mjw25/ECE411_Team10_F19/Initial Perf Board.jpg

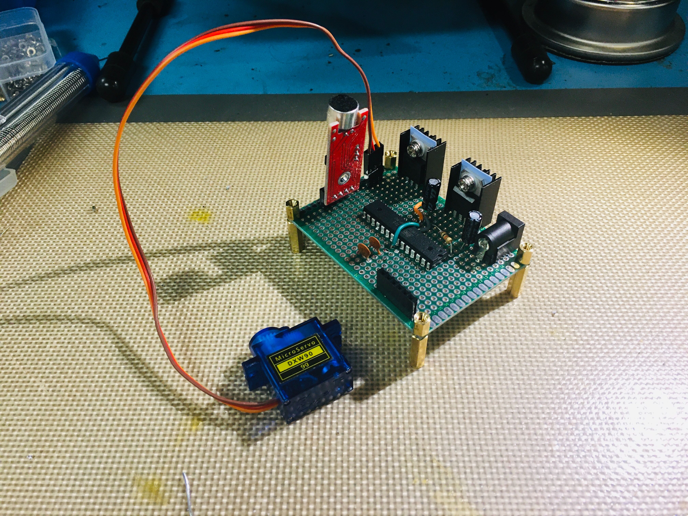
Initial Perf Board.jpg
