mjw25/ECE411_Team10_F19/Breadboard Preliminary Prototype.png

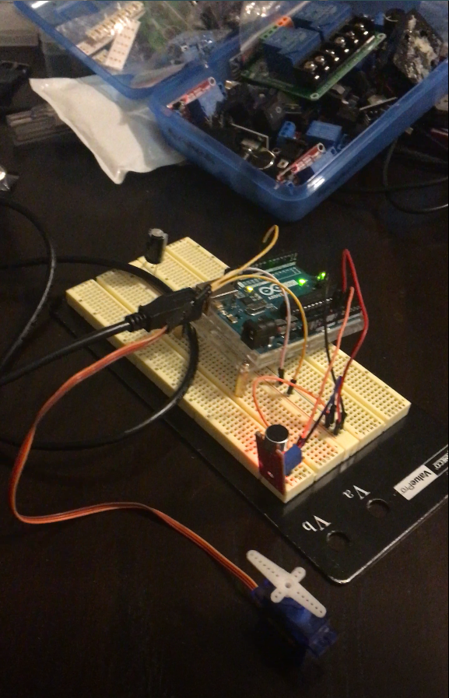
Breadboard Preliminary Prototype.png
