mjw25/ECE411_Team10_F19/README.md

# ECE411_Team10_F19
Practicum Project for ECE411 at PSU, Team 10, Fall 2019
