mjw25/ECE411_Team10_F19/Initial Breadboard Code.png

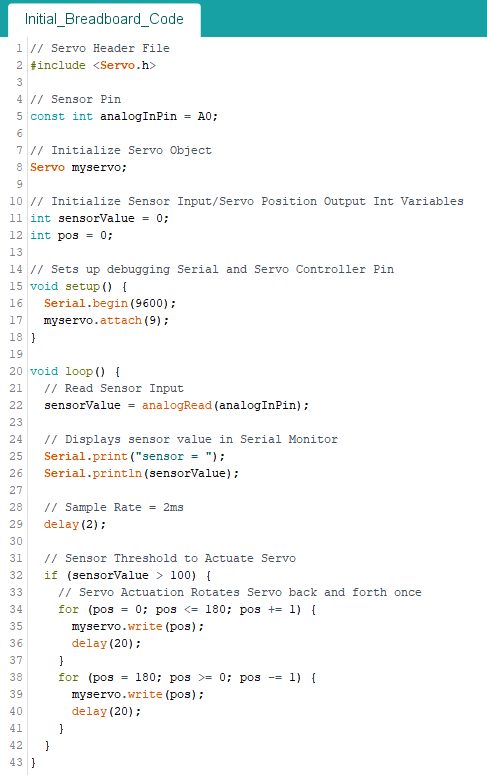
Initial Breadboard Code.png
