mjw25/ECE411_Team10_F19/Level 0.png

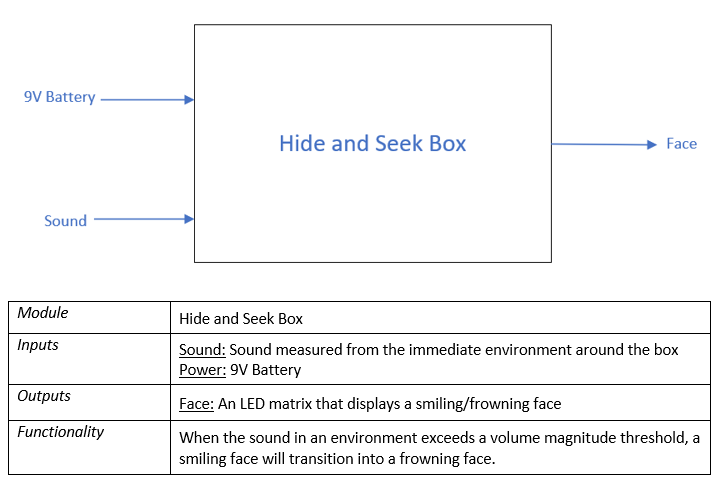
Level 0.png
