mjw25/ECE411_Team10_F19/Level 1 - Module 1.png

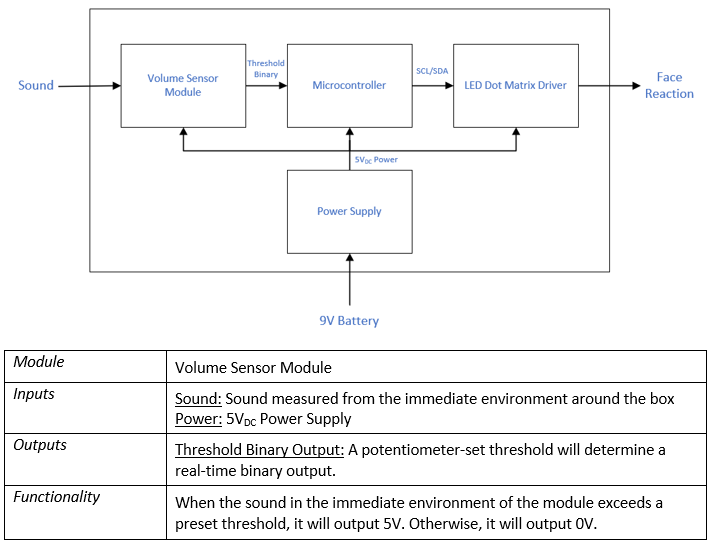
Level 1 - Module 1.png
