mjw25/ECE411_Team10_F19/Level 1 - Modules 2, 3, 4.png

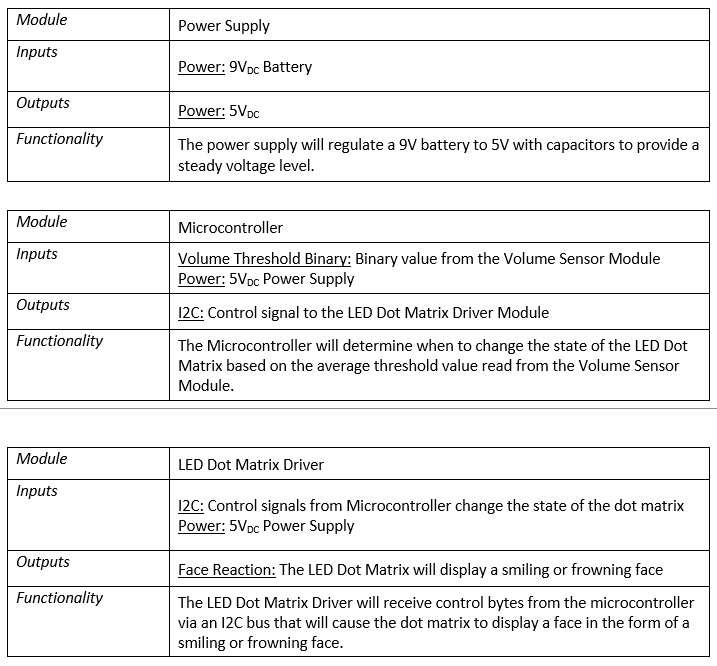
Level 1 - Modules 2, 3, 4.png
