mjw25/ECE411_Team10_F19/OSH_PCB_Top_Bottom.PNG

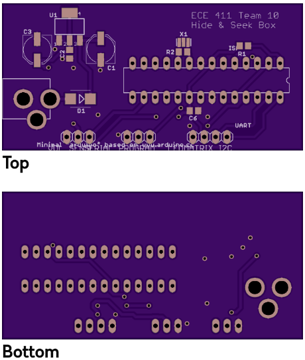
OSH_PCB_Top_Bottom.PNG
