mjw25/ECE411_Team10_F19/Preliminary Schematic.png

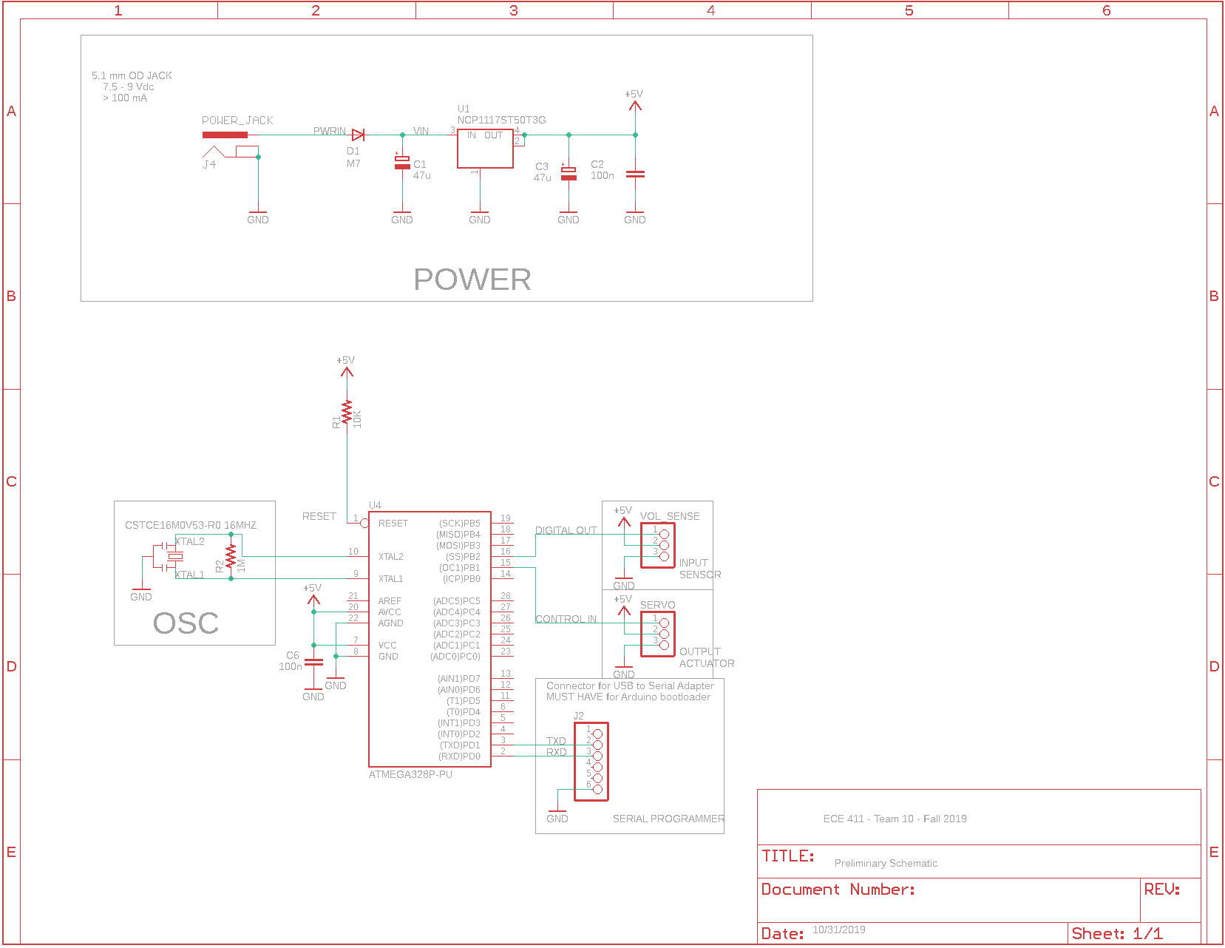
Preliminary Schematic.png
