mjw25/ECE411_Team10_F19/Project View.png

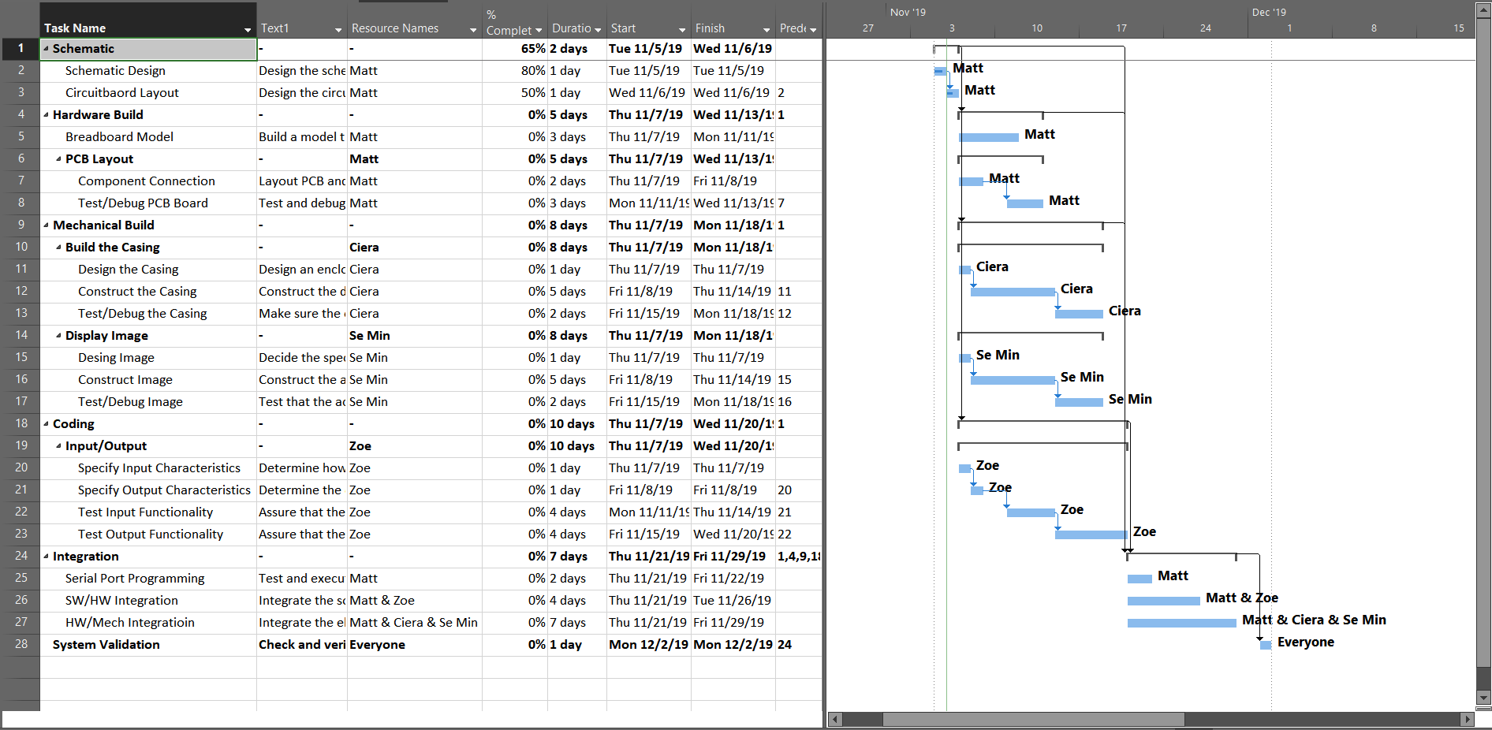
Project View.png
