mjw25/ECE411_Team10_F19/Routed Board - Prototype.png

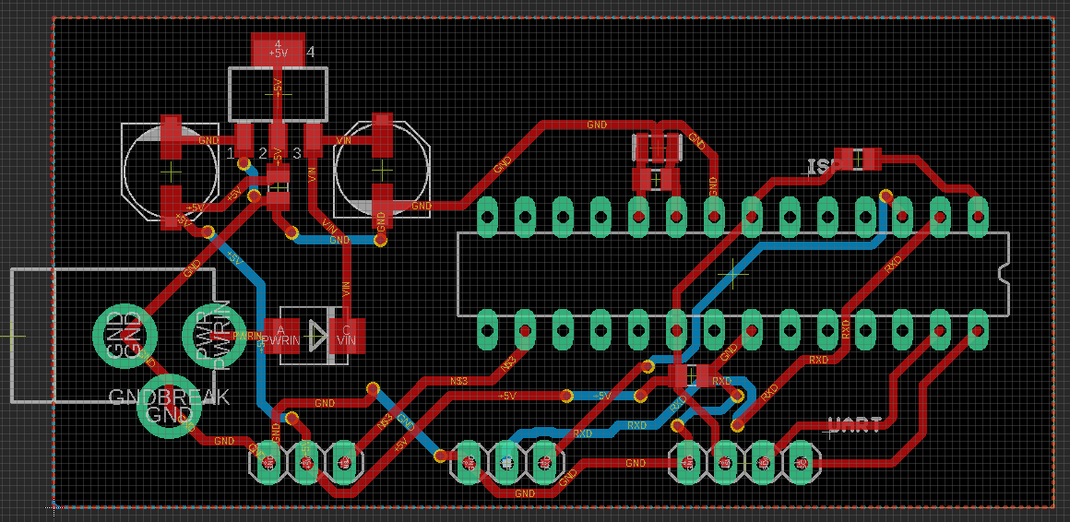
Routed Board - Prototype.png
