mjw25/ECE411_Team10_F19/Updated_Board_11-20.png

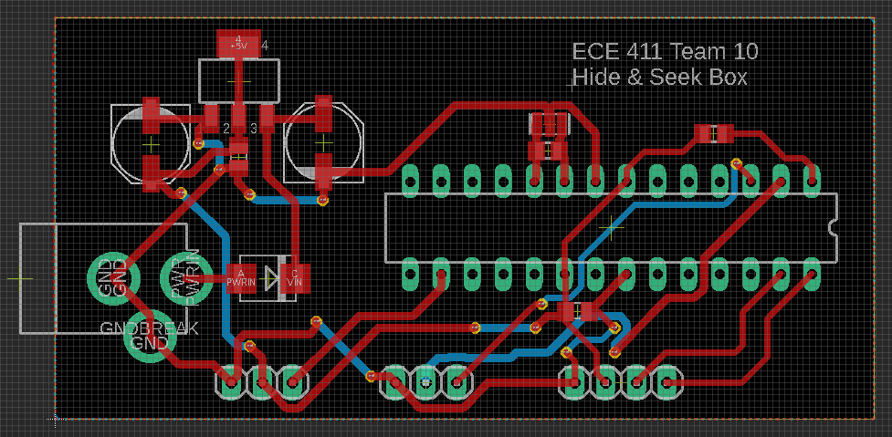
Updated_Board_11-20.png
