mjw25/ECE411_Team10_F19/Prototype BOM.xlsx

Sheet: BillOfMaterials
Hide and Seek Box
 | Assembly Name : | Prototype Assembly |  |  |  |  |  |  | [42]
 | Assembly Number : | 1
 | Assembly Revision : | 1
 | Approval Date : | 2019-11-13
 | Part Count : | 15
 | Total Cost : | $16.34
Part # | Part Name | Description | Package | Manufacturer | Distributor | Link | Qty | Units | Picture | Unit Cost | Cost
C0805X104K5RAC3316 | C2, C6 | 100n Ceramic Capacitor | C0805 | Kemet | Mouser | Link (https://www.mouser.com/ProductDetail/KEMET/C0805X104K5RAC3316) | 2 | Pieces |  | $0.34 | $0.68
EEE-TC1V470P | C1, C3 | 47u Electrolytic Capacitor | Panasonic D | Panasonic | Mouser | Link (https://www.mouser.com/ProductDetail/Panasonic/EEE-TC1V470P) | 2 | Pieces |  | $0.95 | $1.90
WCR0805-10KFI | R1 | SMD 10K-Ohm Thick Film Resistor | R0805 | Welwyn Components/ TT Electronics | Mouser | Link (https://www.mouser.com/ProductDetail/Welwyn-Components-TT-Electronics/WCR0805-10KFI) | 1 | Pieces |  | $0.10 | $0.10
CR0805-FX-1004ELF | R2 | SMD 1M-Ohm Thick Film Resistor | R0805 | Bourns | Mouser | Link (https://www.mouser.com/ProductDetail/Bourns/CR0805-FX-1004ELF) | 1 | Pieces |  | $0.10 | $0.10
UA78M05IDCYR | U1 | 5V Regulator - NPC1117ST50T3G | SOT223 | Texas Instruments | Mouser | Link (https://www.mouser.com/ProductDetail/Texas-Instruments/UA78M05IDCYR) | 1 | Pieces |  | $0.62 | $0.62
P6SMB39CA-Q | D1 | TVS Diode 600W | SMB | Bourns | Mouser | Link (https://www.mouser.com/ProductDetail/Bourns/P6SMB39CA-Q) | 1 | Pieces |  | $0.46 | $0.46
30.359 | N/A | Header Pins | Header Pins | Altech | Mouser | Link (https://www.mouser.com/ProductDetail/Altech/30359) | 2 | Pieces |  | $1.28 | $2.56
ATMEGA328P-PU | U4 | 8-Bit Microcontroller | DIL28-3 | Microchip Technology/ Atmel | Mouser | Link (https://www.mouser.com/ProductDetail/Microchip-Technology-Atmel/ATMEGA328P-PU) | 1 | Pieces |  | $2.14 | $2.14
CSTCE16M0V53A-R0 | X1 | 16MHz Resonator | CSTCE16M0V53 | Murata Electronics | element14 | Link (https://sg.element14.com/murata/cstce16m0v53-r0/resonator-smd-16mhz/dp/1401454?CMP=GRHB-OCTOPART) | 1 | Pieces |  | $0.58 | $0.58
PRT-10811 | J4 | Power Jack | Barrel Jack | SparkFun | Mouser | Link (https://www.mouser.com/ProductDetail/SparkFun/PRT-10811) | 1 | Pieces |  | $0.95 | $0.95
HT16K33 | N/A | I2C 8x8 LED Matrix | N/A | Keyestudio | Amazon | Link (https://www.amazon.com/KEYESTUDIO-Matrix-HT16K33-Arduino-Raspberry/dp/B0179AGI9K) | 1 | Pieces |  | $4.33 | $4.33
B07R452F6J | N/A | Microphone Sensor | N/A | Devmo | Amazon | Link (https://www.amazon.com/gp/product/B07R452F6J/ref=ppx_yo_dt_b_asin_title_o04_s01?ie=UTF8&psc=1) | 1 | Pieces |  | $1.92 | $1.92
 | Total |  |  |  |  |  | 15 |  |  |  | $16.34

Sheet: Revisions
Revision History
 | Assembly Name :
 | Assembly Number :
Revision | Revision Summary | Approval Date
