mjw25/ECE411_Team10_F19/BOM - Prototype.png

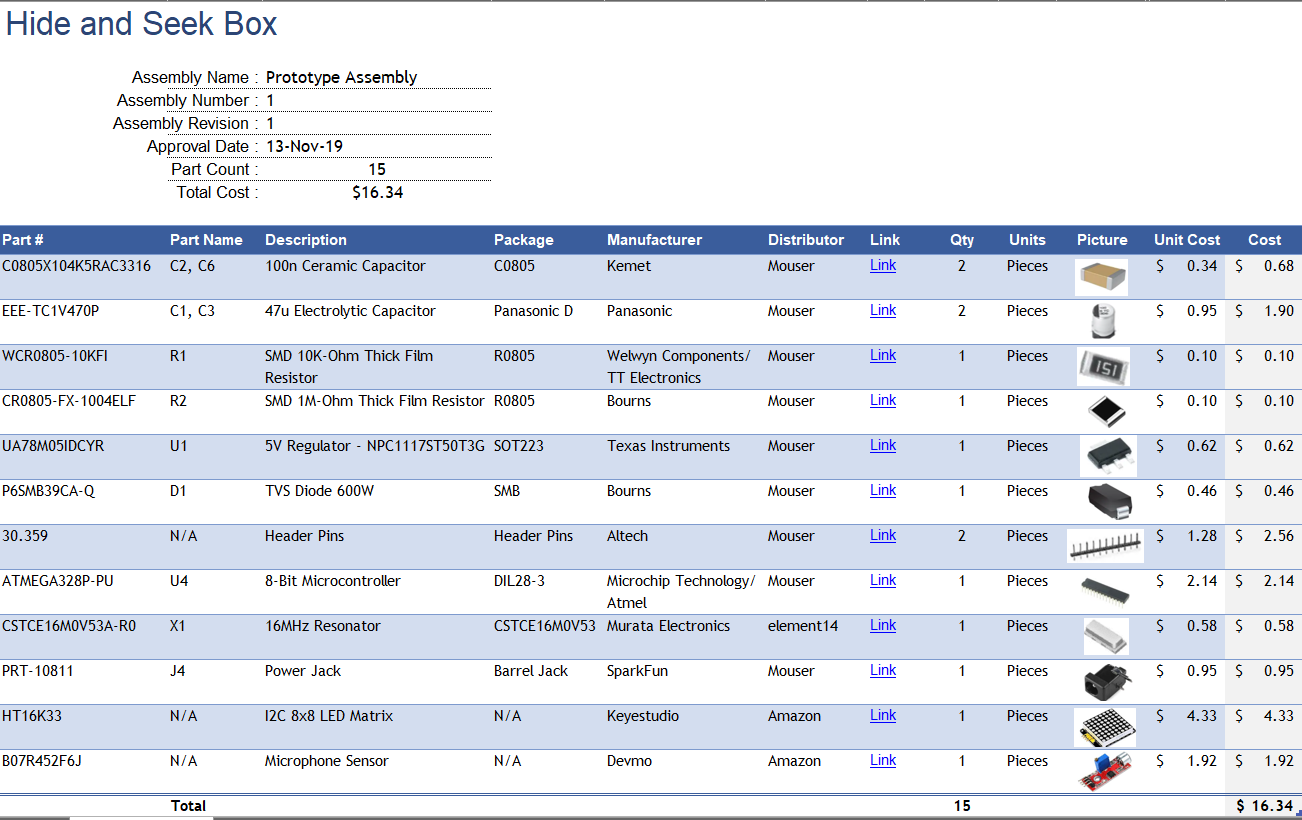
BOM - Prototype.png
