mjw25/ECE411_Team10_F19/ECE411-Box.stl

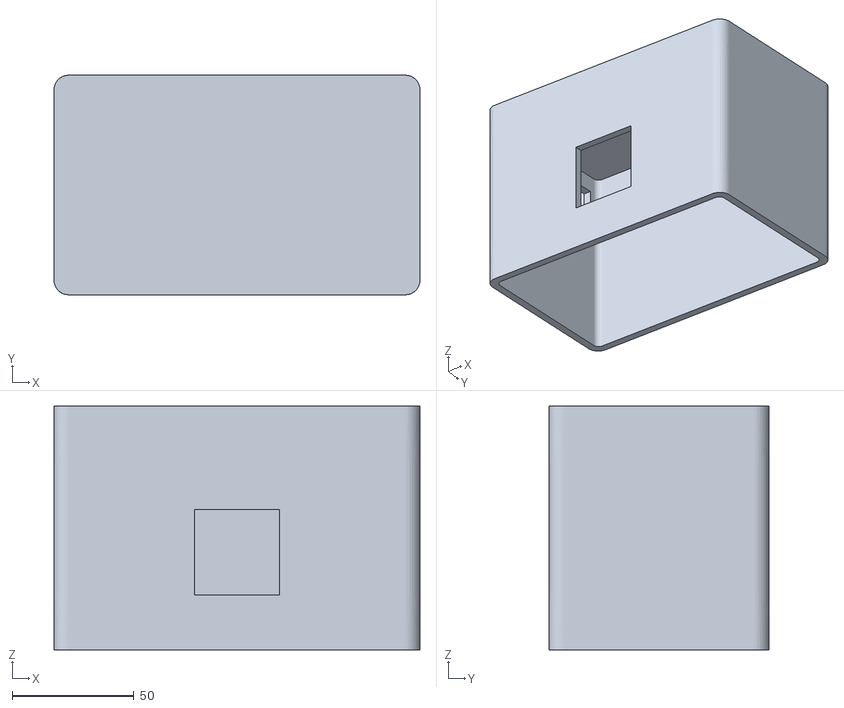
[picture p16: CAD file, 2019-12-13]
ECE411-Box.stl
150.0 x 90.0 x 100.0
