mjw25/ECE411_Team10_F19/ECE411-Lid.stl

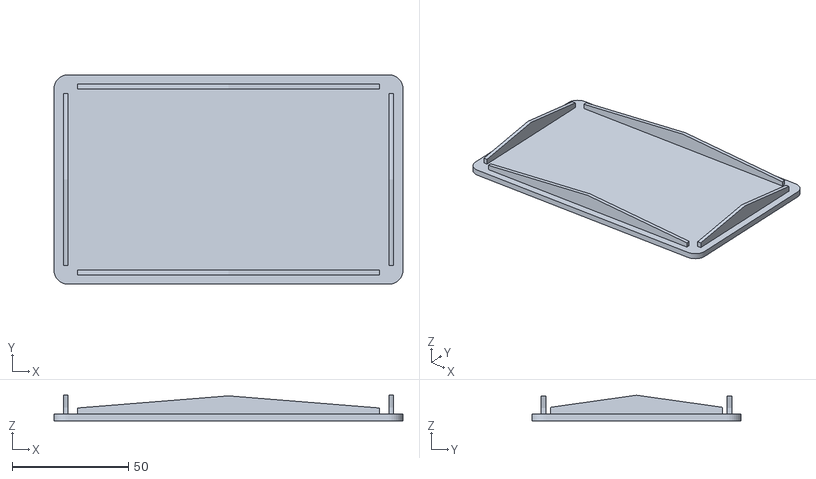
[picture p17: CAD file, 2019-12-13]
ECE411-Lid.stl
150.0 x 90.0 x 11.0
