mjw25/ECE411_Team10_F19/Updated_Schematic_11-20.brd

## EAGLE design Updated_Schematic_11-20.brd (2019-11-20)

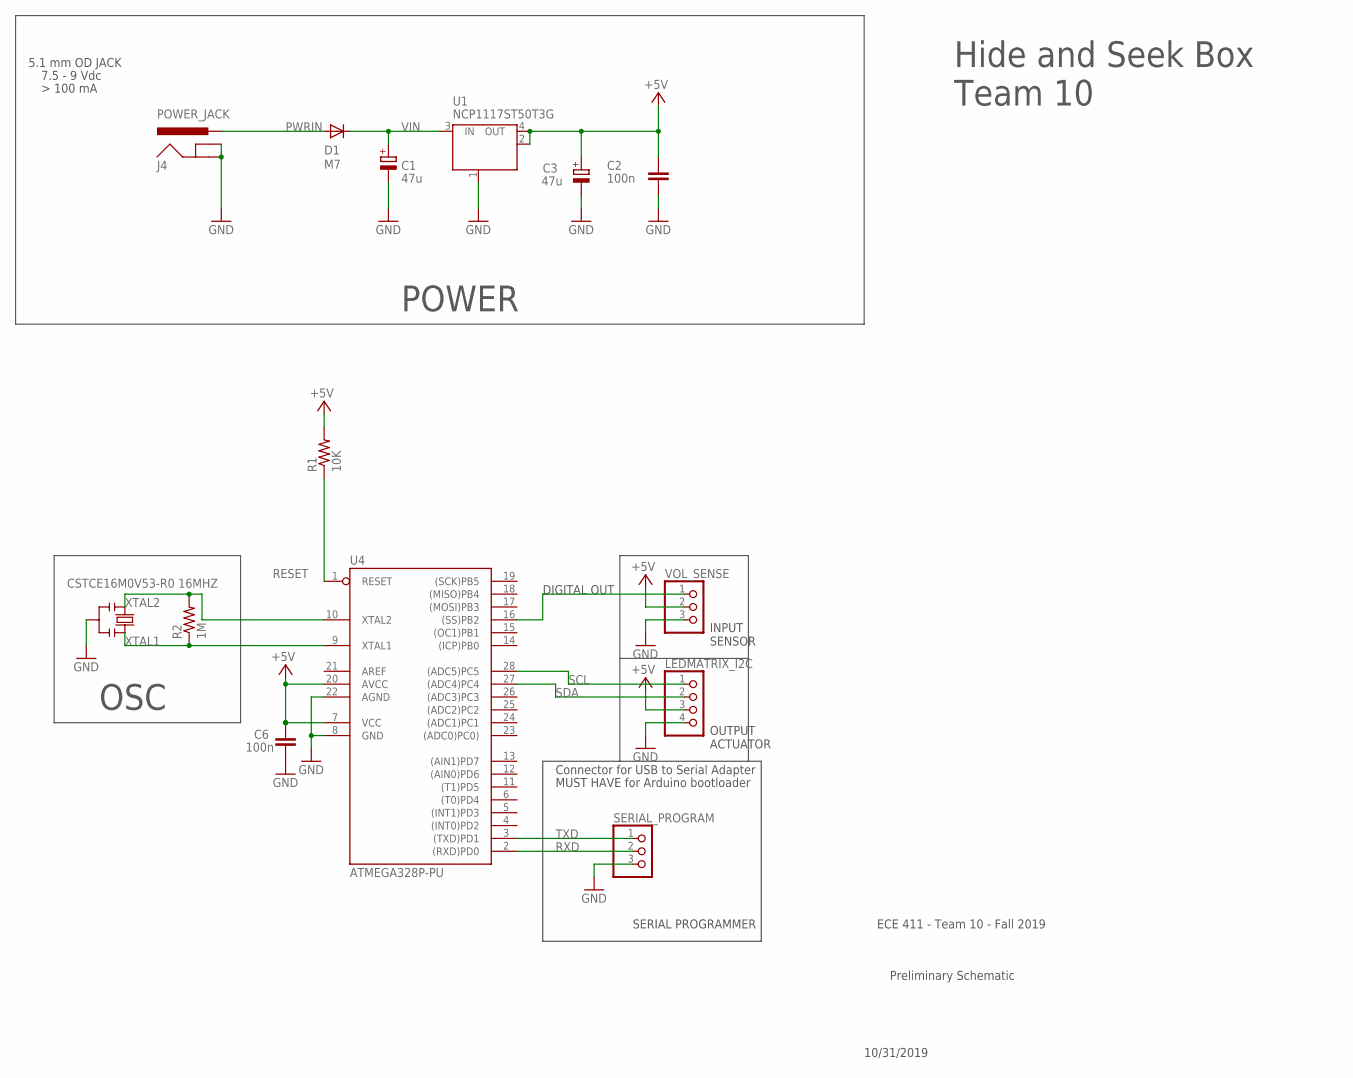
[picture p18: schematic Updated_Schematic_11-20.sch]

Parts:
C1, C3: 47u; PANASONIC_D
C2, C6: 100n; C0805
D1: M7; SMB
J4: POWER_JACK; POWER_JACK_PTH
LEDMATRIX_I2C: PINHD-1X4; 1X04
R1: 10K; R0805
R2: 1M; R0805
SERIAL_PROGRAM: PINHD-1X3; 1X03
U1: NCP1117ST50T3G; SOT223
U4: ATMEGA328P-PU; DIL28-3
VOL_SENSE: PINHD-1X3; 1X03
X1: CSTCE16M0V53-R0 16MHZ; RESONATOR

Connections:
+5V: C2.2, C3.+, C6.2, LEDMATRIX_I2C.3, R1.2, U1.2 (OUT), U1.4 (OUT), U4.7 (VCC), U4.20 (AVCC), VOL_SENSE.2
GND: C1.-, C2.1, C3.-, C6.1, J4.GND, J4.GNDBREAK, LEDMATRIX_I2C.4, SERIAL_PROGRAM.3, U1.1 (GND/ADJ), U4.8 (GND), U4.22 (AGND), VOL_SENSE.3, X1.2
unnamed: U4.16 ((SS)PB2), VOL_SENSE.1
PWRIN: D1.A, J4.PWR
RESET: R1.1, U4.1 (RESET)
RXD: SERIAL_PROGRAM.2, U4.2 ((RXD)PD0)
SCL: LEDMATRIX_I2C.1, U4.28 ((ADC5)PC5)
SDA: LEDMATRIX_I2C.2, U4.27 ((ADC4)PC4)
TXD: SERIAL_PROGRAM.1, U4.3 ((TXD)PD1)
VIN: C1.+, D1.C, U1.3 (IN)
XTAL1: R2.1, U4.9 (XTAL1), X1.3
XTAL2: R2.2, U4.10 (XTAL2), X1.1

Notes on the sheet:
7.5 - 9 Vdc
POWER
OSC
5.1 mm OD JACK
Connector for USB to Serial Adapter
MUST HAVE for Arduino bootloader
DIGITAL OUT
SERIAL PROGRAMMER
INPUT SENSOR
OUTPUT ACTUATOR
Preliminary Schematic
10/31/2019
ECE 411 - Team 10 - Fall 2019
Hide and Seek Box Team 10

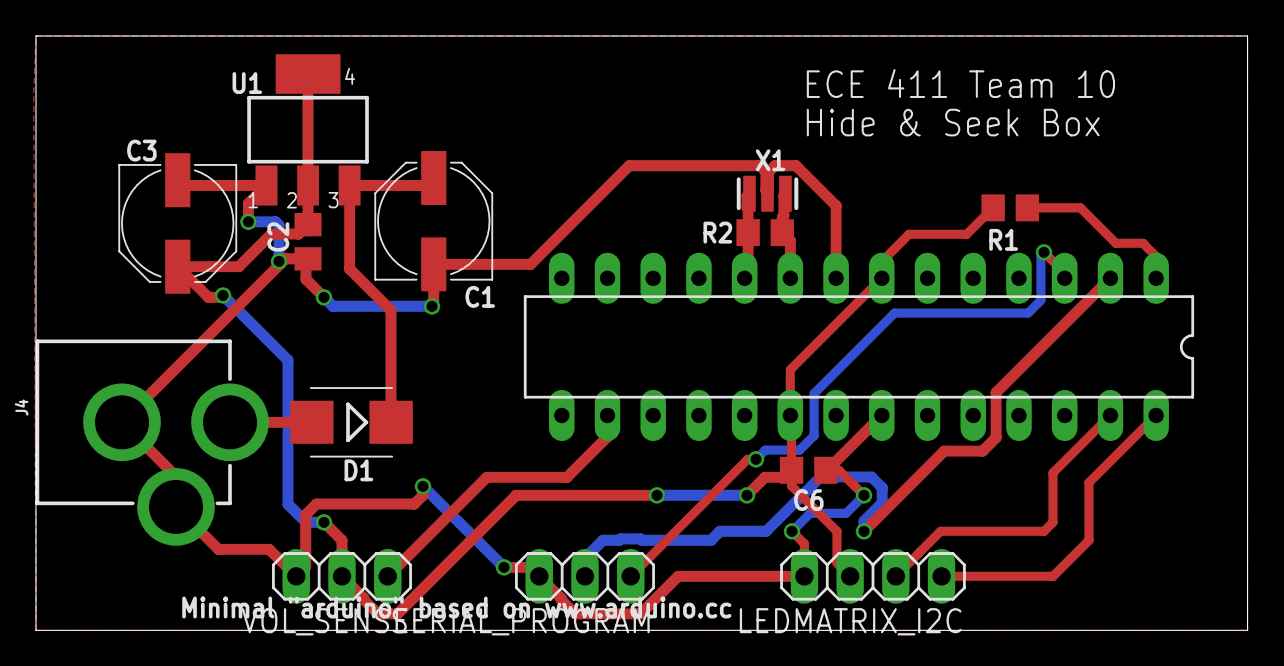
[picture p19: board Updated_Schematic_11-20.brd from above]

Board: 2 copper layers, 67.3 x 33.0 mm, 14 parts (0 on the bottom side), 12 nets.
