mjw25/ECE411_Team10_F19/tooloud.ino

#include <Wire.h>
#include <Adafruit_GFX.h>
#include "Adafruit_LEDBackpack.h"

Adafruit_8x8matrix matrix = Adafruit_8x8matrix();

void setup() {
  Serial.begin(9600);
  Serial.println("8x8 LED Matrix Test");
  matrix.begin(0x70);  // pass in the address
}

void loop() {
  matrix.setTextSize(1);
  matrix.setTextWrap(false);  // we dont want text to wrap so it scrolls nicely
  matrix.setTextColor(LED_ON);
  for (int8_t x=0; x>=-60; x--) {
    matrix.clear();
    matrix.setCursor(x,0);
    matrix.print("Too Loud!!!");
    matrix.writeDisplay();
    delay(100);
  }
  matrix.setRotation(0);
}
